Windfisch/robocat/pcb/pcb/pcb.kicad_pcb

## KiCad design pcb/pcb/pcb.kicad_pcb (2024-05-30)

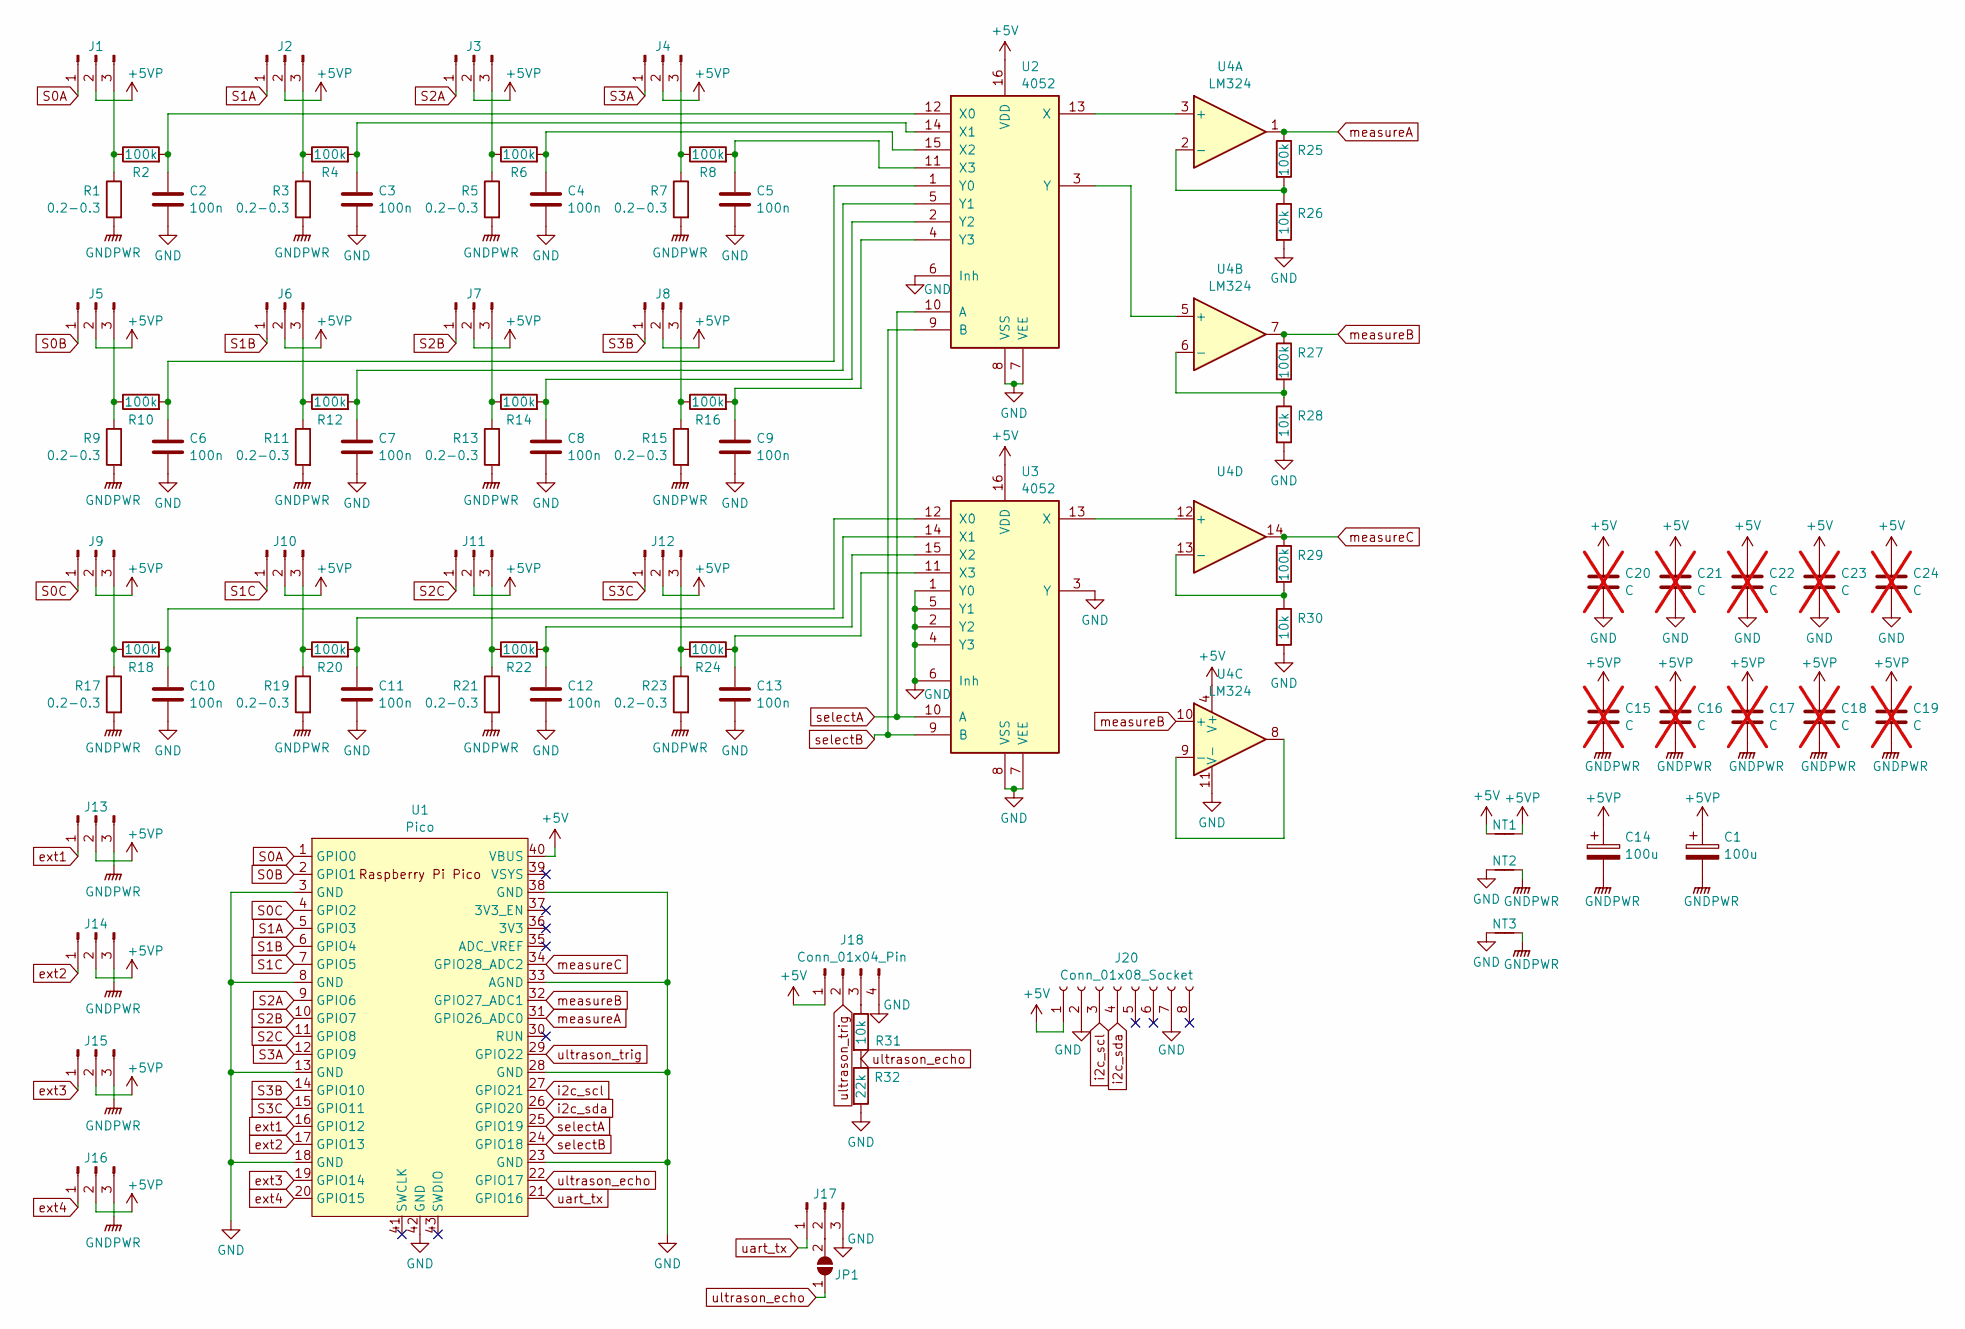
[picture p1: schematic pcb.kicad_sch]

Parts:
C1, C14: 100u; CP_Radial_D5.0mm_P2.50mm
C2, C3, C4, C5, C6, C7, C8, C9, C10, C11, C12, C13: 100n; C_0805_2012Metric
C15, C16, C17, C18, C19, C20, C21, C22, C23, C24: C; C_0805_2012Metric; not fitted
J1, J2, J3, J4, J5, J6, J7, J8, J9, J10, J11, J12, J13, J14, J15, J16, J17: Conn_01x03_Pin; PinHeader_1x03_P2.54mm_Vertical
J18: Conn_01x04_Pin; PinHeader_1x04_P2.54mm_Vertical
J20: Conn_01x08_Socket; GY-521
JP1: SolderJumper_2_Open; SolderJumper-2_P1.3mm_Open_Pad1.0x1.5mm
NT1, NT2, NT3: NetTie_2; NetTie-2_SMD_Pad0.5mm
R1, R3, R5, R7, R9, R11, R13, R15, R17, R19, R21, R23: 0.2-0.3; R_0805_2012Metric
R2, R4, R6, R8, R10, R12, R14, R16, R18, R20, R22, R24, R25, R27, R29: 100k; R_0805_2012Metric
R26, R28, R30, R31: 10k; R_0805_2012Metric
R32: 22k; R_0805_2012Metric
U1: Pico; RPi_Pico_SMD_TH
U2, U3: 4052; DIP-16_W7.62mm
U4: LM324; DIP-14_W7.62mm

Connections:
+5V: C20.1, C21.1, C22.1, C23.1, C24.1, J18.1, J20.1, NT1.1, U1.40 (VBUS), U2.16 (VDD), U3.16 (VDD), U4.4 (V+)
+5VP: C1.1, C14.1, C15.1, C16.1, C17.1, C18.1, C19.1, J1.2, J2.2, J3.2, J4.2, J5.2, J6.2, J7.2, J8.2, J9.2, J10.2, J11.2, J12.2, J13.2, J14.2, J15.2, J16.2, NT1.2
GND: C2.2, C3.2, C4.2, C5.2, C6.2, C7.2, C8.2, C9.2, C10.2, C11.2, C12.2, C13.2, C20.2, C21.2, C22.2, C23.2, C24.2, J17.3, J18.4, J20.2, J20.7, NT2.1, NT3.1, R26.2, R28.2, R30.2, R32.2, U1.3 (GND), U1.8 (GND), U1.13 (GND), U1.18 (GND), U1.23 (GND), U1.28 (GND), U1.33 (AGND), U1.38 (GND), U1.42 (GND), U2.6 (Inh), U2.7 (VEE), U2.8 (VSS), U3.1 (Y0), U3.2 (Y2), U3.3 (Y), U3.4 (Y3), U3.5 (Y1), U3.6 (Inh), U3.7 (VEE), U3.8 (VSS), U4.11 (V-)
GNDPWR: C1.2, C14.2, C15.2, C16.2, C17.2, C18.2, C19.2, J13.3, J14.3, J15.3, J16.3, NT2.2, NT3.2, R1.2, R3.2, R5.2, R7.2, R9.2, R11.2, R13.2, R15.2, R17.2, R19.2, R21.2, R23.2
unnamed: J1.3, R1.1, R2.1
unnamed: J2.3, R3.1, R4.1
unnamed: J3.3, R5.1, R6.1
unnamed: J4.3, R7.1, R8.1
unnamed: J5.3, R9.1, R10.1
unnamed: J6.3, R11.1, R12.1
unnamed: J7.3, R13.1, R14.1
unnamed: J8.3, R15.1, R16.1
unnamed: J9.3, R17.1, R18.1
unnamed: J10.3, R19.1, R20.1
unnamed: J11.3, R21.1, R22.1
unnamed: J12.3, R23.1, R24.1
unnamed: J17.2, JP1.2 (B)
unnamed: J18.3, R31.1
unnamed: C2.1, R2.2, U2.12 (X0)
unnamed: C3.1, R4.2, U2.14 (X1)
unnamed: C4.1, R6.2, U2.15 (X2)
unnamed: C5.1, R8.2, U2.11 (X3)
unnamed: U2.13 (X), U4.3 (+)
unnamed: C6.1, R10.2, U2.1 (Y0)
unnamed: C7.1, R12.2, U2.5 (Y1)
unnamed: C8.1, R14.2, U2.2 (Y2)
unnamed: C9.1, R16.2, U2.4 (Y3)
unnamed: U2.3 (Y), U4.5 (+)
unnamed: C10.1, R18.2, U3.12 (X0)
unnamed: C11.1, R20.2, U3.14 (X1)
unnamed: C12.1, R22.2, U3.15 (X2)
unnamed: C13.1, R24.2, U3.11 (X3)
unnamed: U3.13 (X), U4.12 (+)
unnamed: R25.2, R26.1, U4.2 (-)
unnamed: R27.2, R28.1, U4.6 (-)
unnamed: U4.8, U4.9 (-)
unnamed: R29.2, R30.1, U4.13 (-)
S0A: J1.1, U1.1 (GPIO0)
S0B: J5.1, U1.2 (GPIO1)
S0C: J9.1, U1.4 (GPIO2)
S1A: J2.1, U1.5 (GPIO3)
S1B: J6.1, U1.6 (GPIO4)
S1C: J10.1, U1.7 (GPIO5)
S2A: J3.1, U1.9 (GPIO6)
S2B: J7.1, U1.10 (GPIO7)
S2C: J11.1, U1.11 (GPIO8)
S3A: J4.1, U1.12 (GPIO9)
S3B: J8.1, U1.14 (GPIO10)
S3C: J12.1, U1.15 (GPIO11)
ext1: J13.1, U1.16 (GPIO12)
ext2: J14.1, U1.17 (GPIO13)
ext3: J15.1, U1.19 (GPIO14)
ext4: J16.1, U1.20 (GPIO15)
i2c_scl: J20.3, U1.27 (GPIO21)
i2c_sda: J20.4, U1.26 (GPIO20)
measureA: R25.1, U1.31 (GPIO26_ADC0), U4.1
measureB: R27.1, U1.32 (GPIO27_ADC1), U4.7, U4.10 (+)
measureC: R29.1, U1.34 (GPIO28_ADC2), U4.14
selectA: U1.25 (GPIO19), U2.10 (A), U3.10 (A)
selectB: U1.24 (GPIO18), U2.9 (B), U3.9 (B)
uart_tx: J17.1, U1.21 (GPIO16)
ultrason_echo: JP1.1 (A), R31.2, R32.1, U1.22 (GPIO17)
ultrason_trig: J18.2, U1.29 (GPIO22)

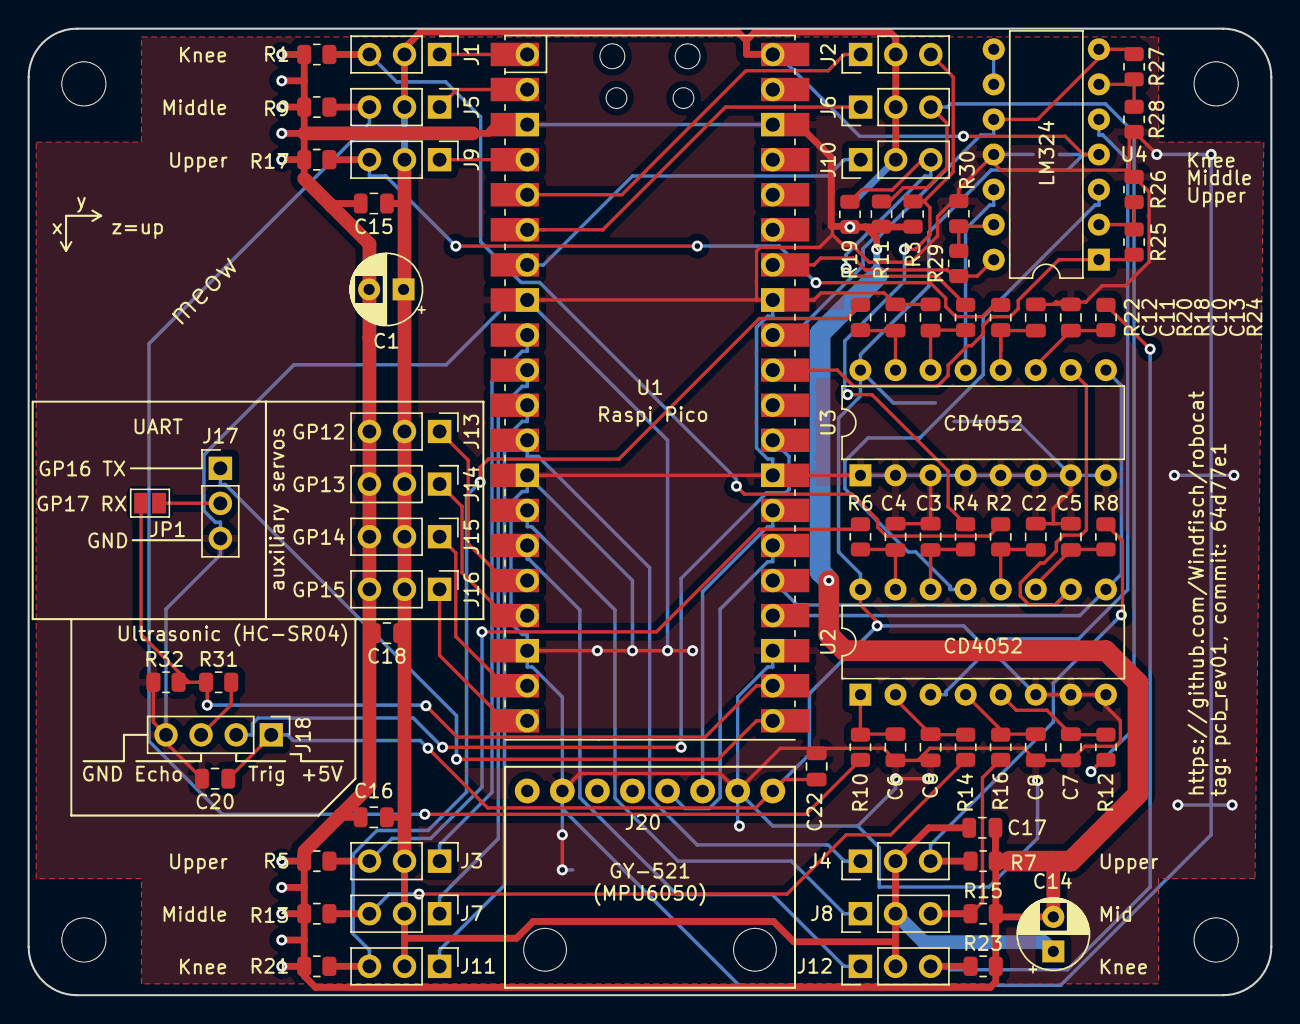
[picture p2: board pcb.kicad_pcb from above]

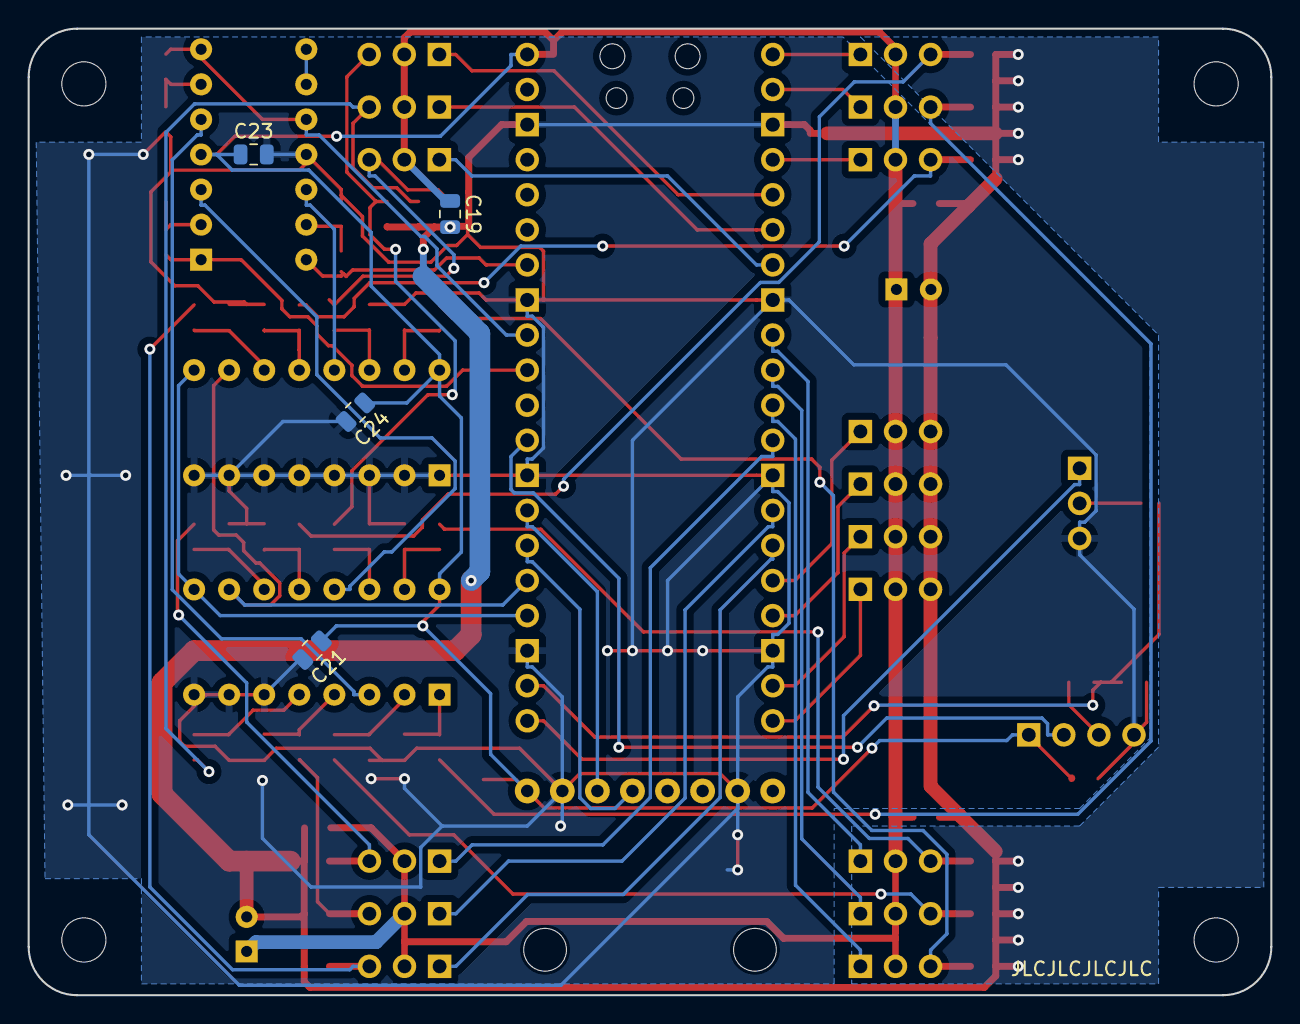
[picture p3: board pcb.kicad_pcb from below]

Board: 2 copper layers, 90.0 x 70.0 mm, 87 parts (4 on the bottom side), 63 nets.

Other parts of the board:
Hole1, Hole2, Hole3, Hole4: MountingHole_3.2mm_M3
