Windfisch/robocat/(commit log)

2024-02-03 chamfer edge
    [01.scad]
2024-03-07 servo movement demo
2024-03-08 power sequencing
2024-05-10 first attempt
    [pcb.kicad_pcb, pcb.kicad_sch]
2024-05-10 cleanup pcb
    [pcb.kicad_pcb]
2024-05-10 cleanup pcb2
    [pcb.kicad_pcb]
2024-05-11 Final PCB revision, i guess?
    [pcb.kicad_pcb, pcb.kicad_sch]
2024-05-11 fillet corners
    [pcb.kicad_pcb]
2024-05-12 final pcb rev01
    [pcb.kicad_pcb]
2024-05-24 Initial CAD
2024-05-24 Support backplate with hole for servo
2024-05-30 new chassis design
2024-05-30 firmware++, adjust to new pcb
2024-05-30 implement current measurement and keep all feet on the ground
    also makes the cat a kind-of-compliant mechanism
2024-06-08 fix paw-to-ground feature
2024-06-14 cascaded regulators
2025-04-20 tiny cad adjustments
2025-04-29 automatic leveling (PI-controller) when standing on two legs
    [log.csv, log2.csv, logB.csv, logC.csv]
2025-06-18 changeable velocity
